M-Welsch/waberinator/readme.md

# Waberinator

Ambient LED driver unit for this guy: https://www.deviantart.com/seggos-artworks
