M-Welsch/waberinator/mech/waberinator_hw2.FCStd

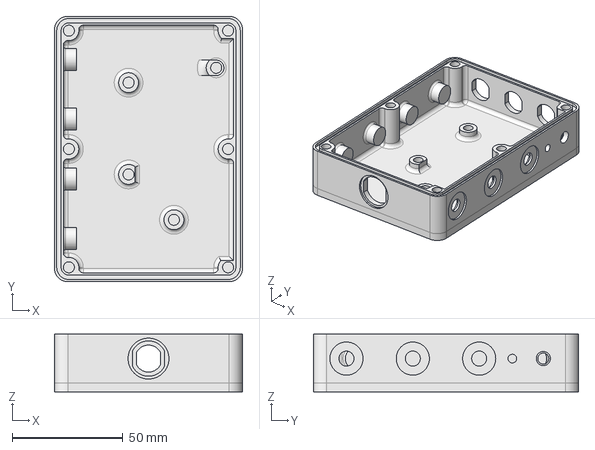
[picture p1: CAD file, 2024-07-26]
mech/waberinator_hw2.FCStd
85.0 x 120.0 x 26.0 mm
