M-Welsch/waberinator/pcb/waberinator_controlboard/design/flat.dxf

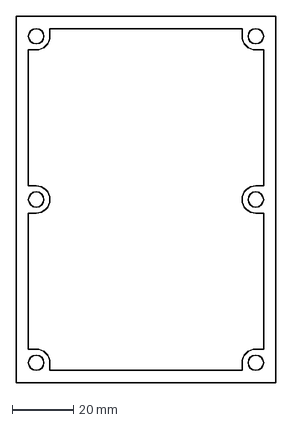
[picture p2: CAD file, 2024-02-20]
pcb/waberinator_controlboard/design/flat.dxf
85.0 x 120.0 mm
