M-Welsch/waberinator/mech/waberinator_connector_test.FCStd

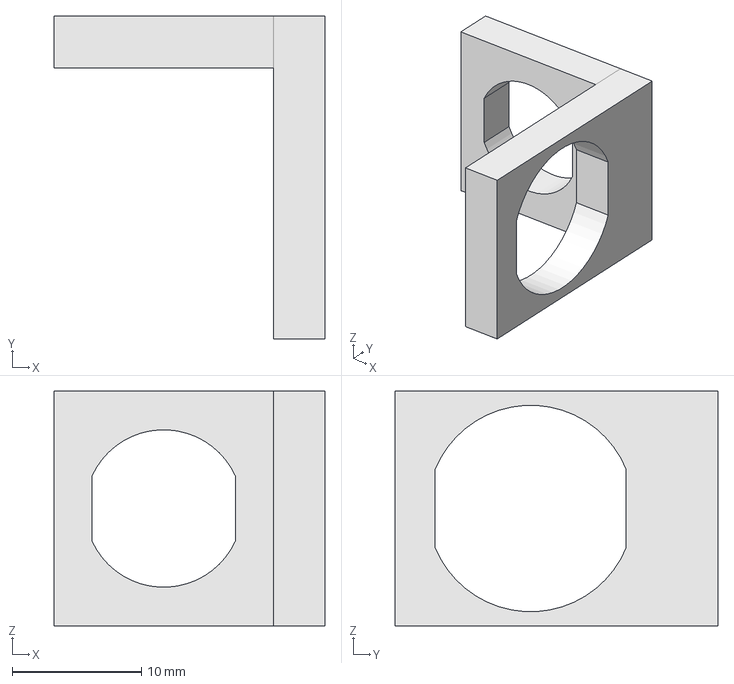
[picture p3: CAD file, 2024-04-21]
mech/waberinator_connector_test.FCStd
21.0 x 25.0 x 18.2 mm
