M-Welsch/waberinator/pcb/waberinator_controlboard/design/bol.dxf

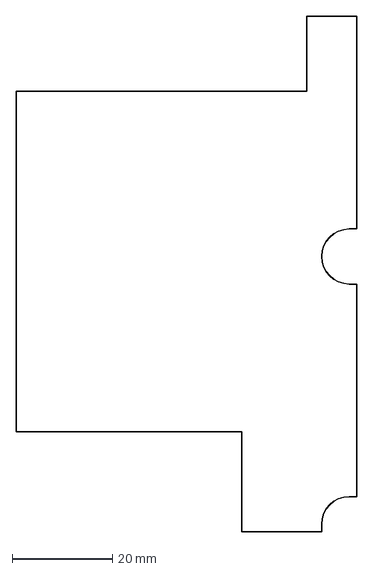
[picture p4: CAD file, 2024-02-20]
pcb/waberinator_controlboard/design/bol.dxf
68.0 x 103.0 mm
