M-Welsch/waberinator/mech/waberinator_hw2_controlboard.FCStd

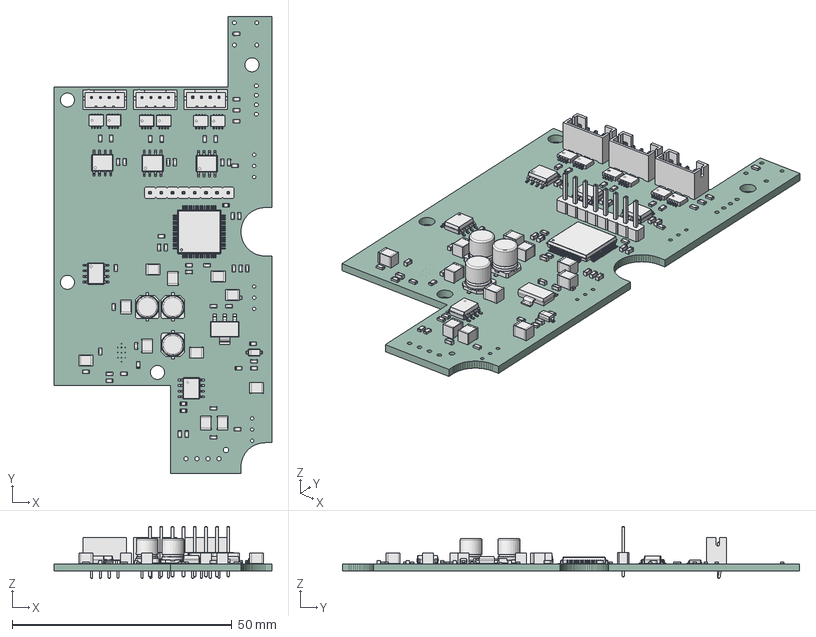
[picture p5: CAD file, 2024-03-04]
mech/waberinator_hw2_controlboard.FCStd
49.5 x 104.0 x 11.9 mm
SOIC_8_39x49mm_P127mm x 4
C_0603_1608Metric x 25
JST_B4B_PH_K x 3
C_1210_3225Metric x 11
R_0603_1608Metric x 27
SOT-1210_LFPAK33 x 6
R_0402_1005Metric x 6
D_SOD_123
C_Elec_5x58 x 3
CQ assembly
LQFP_64_10x10mm_P05mm
SOT_223
PinHeader_1x08_P254mm_Vertical
Waberinator_hw2 PCB
