M-Welsch/waberinator/mech/magnet_d12x3.FCStd

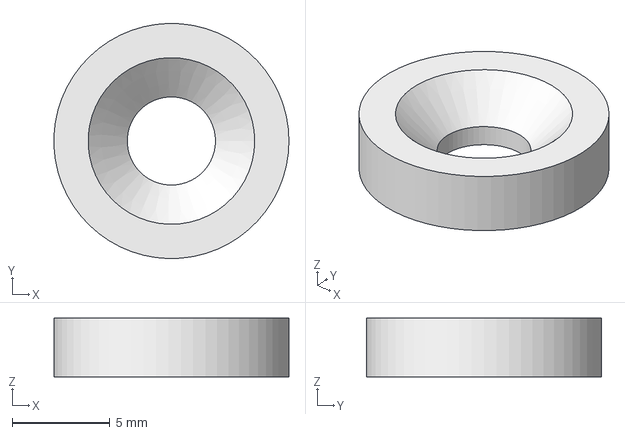
[picture p6: CAD file, 2024-02-18]
mech/magnet_d12x3.FCStd
12.0 x 12.0 x 3.00 mm
