M-Welsch/waberinator/mech/pushbutton_cover_v1.3mf

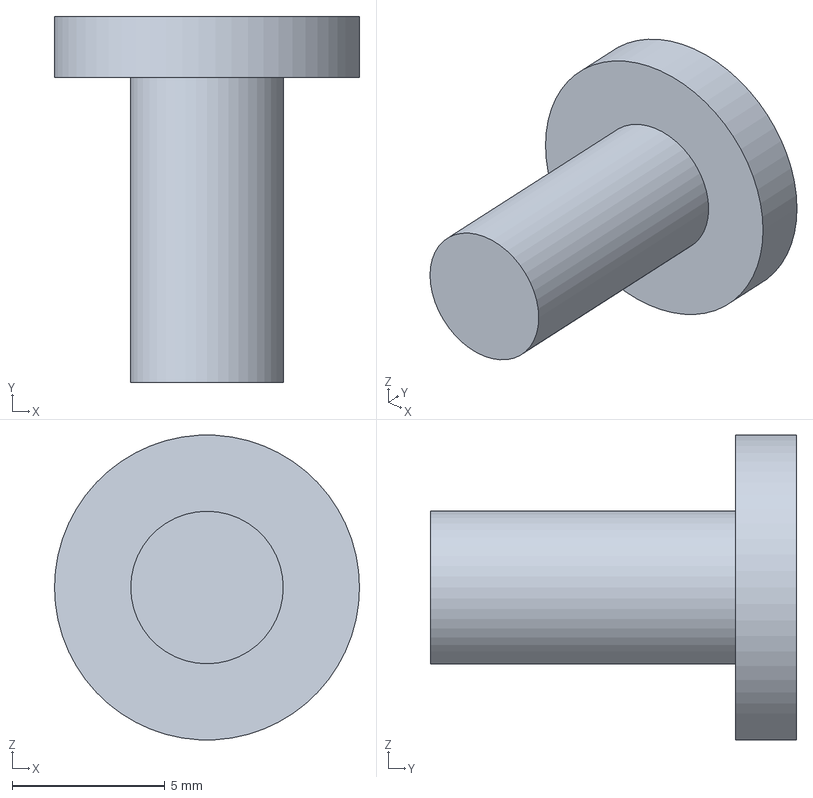
[picture p7: CAD file, 2024-02-17]
mech/pushbutton_cover_v1.3mf
10.0 x 12.0 x 9.99 mm
