M-Welsch/waberinator/mech/pushbutton_cover.FCStd

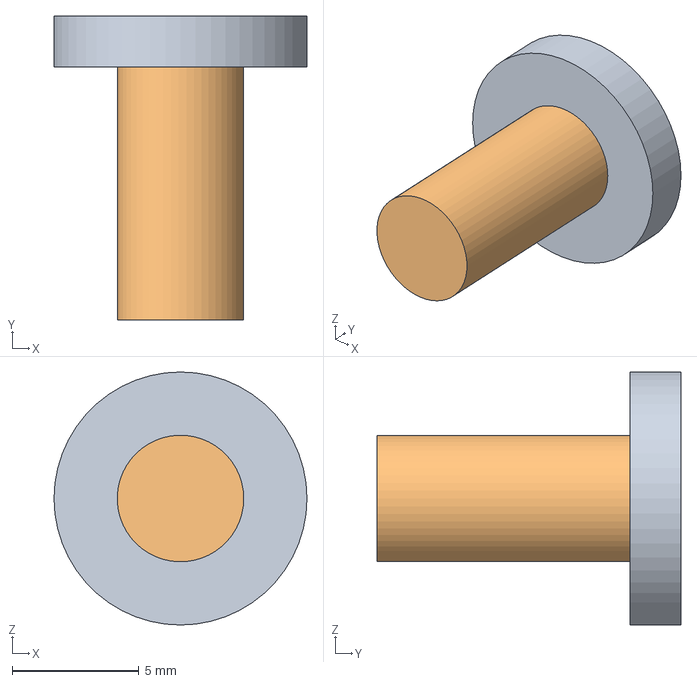
[picture p8: CAD file, 2024-01-04]
mech/pushbutton_cover.FCStd
10.0 x 12.0 x 10.0 mm
