M-Welsch/waberinator/pcb/waberinator_controlboard/design/Waberinator_hw2.kicad_pcb

## KiCad design pcb/waberinator_controlboard/design/Waberinator_hw2.kicad_pcb (2024-07-26)

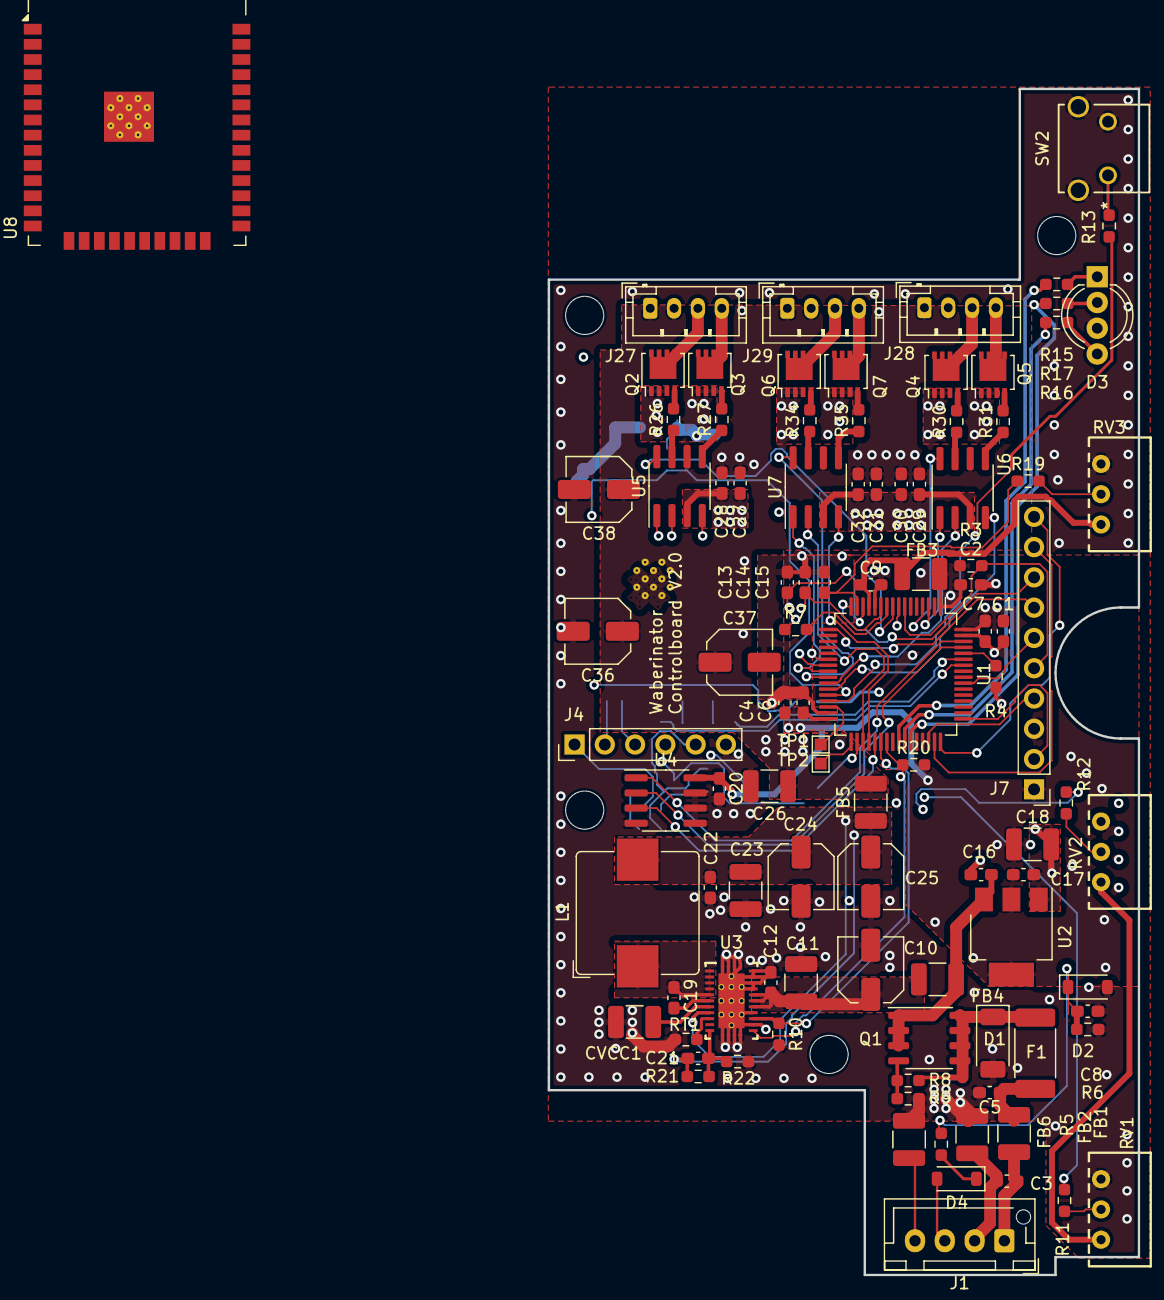
[picture p9: board Waberinator_hw2.kicad_pcb from above]

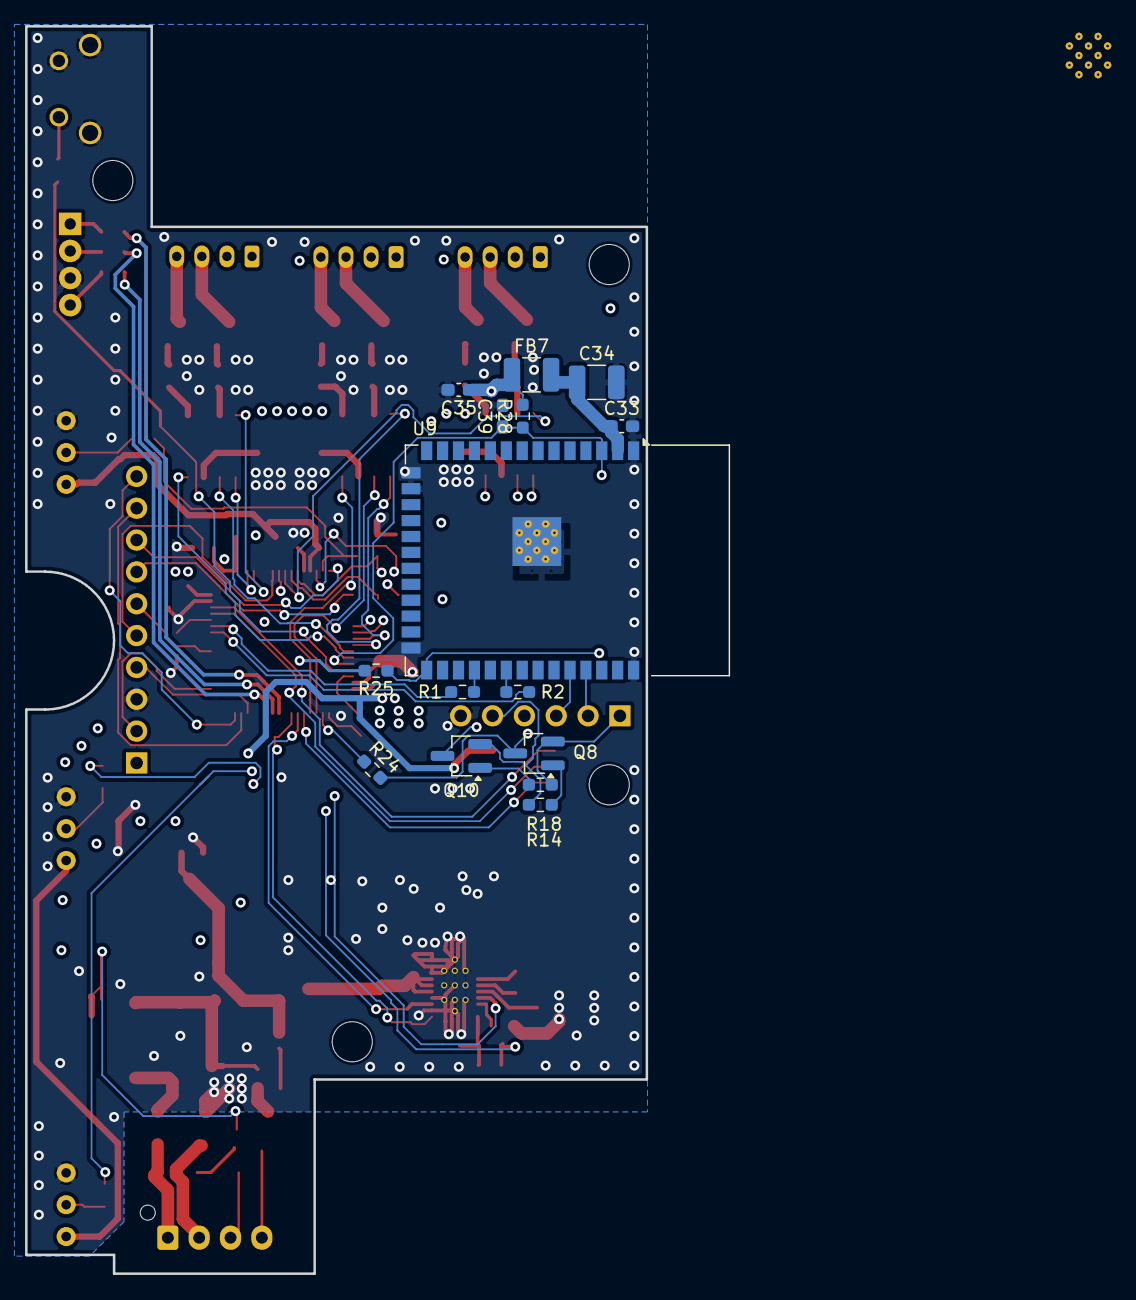
[picture p10: board Waberinator_hw2.kicad_pcb from below]

Board: 4 copper layers, 49.5 x 99.5 mm, 120 parts (15 on the bottom side), 98 nets.

Parts:
C1, C27, C29, C31, C39: 1µF; C_0603_1608Metric_Pad1.08x0.95mm_HandSolder
C2, C4, C6, C7, C8, C9, C16, C17, C20, C28, C30, C32, C33, C35: 100nF; C_0603_1608Metric_Pad1.08x0.95mm_HandSolder
C3, C5: C_0603_1608Metric_Pad1.08x0.95mm_HandSolder
C10, C24, C25, C36, C37, C38: 56µF; C_Elec_5x5.8
C11, C23, C26: 10µF; C_1210_3225Metric_Pad1.33x2.70mm_HandSolder
C12: 47nF; C_0603_1608Metric_Pad1.08x0.95mm_HandSolder
C13, C14, C15: 10n; C_0603_1608Metric_Pad1.08x0.95mm_HandSolder
C18: 22µF; C_1210_3225Metric_Pad1.33x2.70mm_HandSolder
C19, C22: 470nF; C_0603_1608Metric_Pad1.08x0.95mm_HandSolder
C21: 6.8pF; C_0603_1608Metric_Pad1.08x0.95mm_HandSolder
C34: 100µF; C_1210_3225Metric_Pad1.33x2.70mm_HandSolder
CVCC1: 2.2µF; C_1210_3225Metric_Pad1.33x2.70mm_HandSolder
D1: 824501121; D_SOD-128
D2, D4: SD103CW-E3-08; D_SOD-123
D3: RGB LED; LED_D5.0mm-4_RGB_Wide_Pins
F1: Fuse_2512_6332Metric_Pad1.52x3.35mm_HandSolder
FB1, FB2, FB3, FB4, FB5, FB6, FB7: FerriteBead; C_1210_3225Metric_Pad1.33x2.70mm_HandSolder
H1, H2, H3, H4: MountingHole; MountingHole_3.2mm_M3_DIN965
J1: Conn_01x04_Pin; JST_XH_B4B-XH-AM_1x04_P2.50mm_Vertical
J4: Conn_01x06; PinHeader_1x06_P2.54mm_Vertical
J7: Conn_01x10_Pin; PinHeader_1x10_P2.54mm_Vertical
J27, J28, J29: Conn_01x04; JST_PH_B4B-PH-K_1x04_P2.00mm_Vertical
L1: 744325330; L_Bourns_SRP1038C_10.0x10.0mm
NT2: NetTie_2; NetTie-2_SMD_Pad0.5mm
Q1: AOSP21321; SO-8_3.9x4.9mm_P1.27mm
Q2, Q3, Q4, Q5, Q6, Q7: SISHA04DN-T1-GE3; LFPAK33
Q8, Q10: Q_NPN_BEC; SOT-23_Handsoldering
R1, R2, R7, R9, R11, R12, R13, R17, R19, R24: 100; R_0603_1608Metric_Pad0.98x0.95mm_HandSolder
R3, R4, R5, R8, R10, R20, R21: 100k; R_0603_1608Metric_Pad0.98x0.95mm_HandSolder
R6: 24,9k; R_0603_1608Metric_Pad0.98x0.95mm_HandSolder
R14, R18, R28: 10k; R_0603_1608Metric_Pad0.98x0.95mm_HandSolder
R15, R16: 120; R_0603_1608Metric_Pad0.98x0.95mm_HandSolder
R22: 14.3k; R_0603_1608Metric_Pad0.98x0.95mm_HandSolder
R25: 5k; R_0603_1608Metric_Pad0.98x0.95mm_HandSolder
R26, R27, R30, R31, R34, R35: 1; R_0603_1608Metric_Pad0.98x0.95mm_HandSolder
RT1: 95k3; R_0603_1608Metric_Pad0.98x0.95mm_HandSolder
RV1: Brightness; poti_3310C-025-103L
RV2: Frequency; poti_3310C-025-103L
RV3: Depth; poti_3310C-025-103L
SW2: sw_te_1-1825027-1
TP1, TP2: TestPoint; TestPoint_Pad_1.0x1.0mm
U1: STM32F030R8Tx; LQFP-64_10x10mm_P0.5mm
U2: AMS1117-3.3; SOT-223-3_TabPin2
U3: LM73606QRNPRQ1; 30-WFQFN-RNP0030A
U4: LM75B; SOIC-8_3.9x4.9mm_P1.27mm
U5, U6, U7: MCP14A0304xMNY; SOIC-8_3.9x4.9mm_P1.27mm
U8: ESP32-WROOM-32
U9: ESP32-S3-WROOM-1

Connections:
+3.3VA: C9.1, FB3.2, RV1.1, RV2.1, RV3.1, U1.13 (VDDA)
+3V3: C1.1, C2.1, C4.1, C6.1, C7.1, C17.1, C18.1, C20.1, C35.1, FB3.1, FB7.1, J7.1, R3.1, R20.2, R25.2, R28.2, U1.1 (VDD), U1.32 (VDD), U1.64 (VDD), U2.2 (VO), U4.8 (+Vs)
/DC_IN+: C3.2, FB1.1, J1.1
/DC_IN-: C3.1, FB2.1, J1.2
/DC_prefuse: C5.1, F1.2, FB1.2
/DC_preprot: D1.1 (A1), F1.1, NT2.2, Q1.5 (D), Q1.6 (D), Q1.7 (D), Q1.8 (D)
/DC_prot: C16.1, FB4.1, Q1.1 (S), Q1.2 (S), Q1.3 (S), U2.3 (VI)
/Two Strings1/gate_a: Q4.4 (G), R30.2
/Two Strings1/gate_b: Q5.4 (G), R31.2
/Two Strings1/low_a: J28.3, Q4.5 (D)
/Two Strings1/low_b: J28.4, Q5.5 (D)
/Two Strings1/out_a: R30.1, U6.7 (OUTA)
/Two Strings1/out_b: R31.1, U6.5 (OUTB)
/Two Strings2/gate_a: Q6.4 (G), R34.2
/Two Strings2/gate_b: Q7.4 (G), R35.2
/Two Strings2/low_a: J29.3, Q6.5 (D)
/Two Strings2/low_b: J29.4, Q7.5 (D)
/Two Strings2/out_a: R34.1, U7.7 (OUTA)
/Two Strings2/out_b: R35.1, U7.5 (OUTB)
/Two Strings/gate_a: Q2.4 (G), R26.2
/Two Strings/gate_b: Q3.4 (G), R27.2
/Two Strings/low_a: J27.3, Q2.5 (D)
/Two Strings/low_b: J27.4, Q3.5 (D)
/Two Strings/out_a: R26.1, U5.7 (OUTA)
/Two Strings/out_b: R27.1, U5.5 (OUTB)
/U0RXD_ESP32: J4.3, U9.36 (RXD0)
/U0TXD_ESP32: J4.2, U9.37 (TXD0)
/U1RXD_ESP32: R2.1, U9.11 (IO18)
/U1TXD_ESP32: R1.1, U9.10 (IO17)
/VLed: C26.1, C27.1, C28.1, C29.1, C30.1, C31.1, C32.1, C36.1, C37.1, C38.1, FB5.2, J27.1, J27.2, J28.1, J28.2, J29.1, J29.2, U5.6 (V+), U6.6 (V+), U7.6 (V+)
/adc_brightness: C13.1, R11.1, U1.14 (PA0)
/adc_depth: C15.1, R19.1, U1.15 (PA1)
/adc_frequency: C14.1, R12.1, U1.11 (PC3)
/bat_kelvin+: D4.2 (A), J1.3
/bat_kelvin-: FB6.1, J1.4
/boot0: R4.2, U1.60 (BOOT0)
/button1: R13.1, U1.29 (PB10)
/esp32_en: C39.1, Q10.3 (C), R28.1, U1.28 (PB2), U9.3 (EN)
/esp32_io0: Q8.3 (C), R24.2, R25.1, U9.27 (IO0)
/esp32_prog_dtr: J4.1, Q8.2 (E), R14.1
/esp32_prog_rts: J4.5, Q10.2 (E), R18.1
/esp32_vdd: C33.1, C34.1, FB7.2, U9.2 (3V3)
/i2c1_scl: U1.61 (PB8), U4.2 (SCL)
/i2c1_sda: U1.62 (PB9), U4.1 (SDA)
/ledstring1_drv_en: U1.8 (PC0), U5.1 (ENA)
/ledstring2_drv_en: U1.9 (PC1), U5.8 (ENB)
/ledstring3_drv_en: U1.3 (PC14), U6.1 (ENA)
/ledstring4_drv_en: U1.4 (PC15), U6.8 (ENB)
/ledstring5_drv_en: U1.24 (PC4), U7.1 (ENA)
/ledstring6_drv_en: U1.25 (PC5), U7.8 (ENB)
/lm75b_int: U1.37 (PC6), U4.3 (O.S.)
/lm73606_en: R10.1, U1.38 (PC7), U3.18 (EN)
/lm73606_out: C21.1, C22.1, C23.1, C24.1, C25.1, FB5.1, L1.2, R21.1, U3.8 (BIAS)
/lm73606_pg: R20.1, U1.39 (PC8), U3.16 (PGOOD)
/lm_fb: C21.2, R21.2, R22.1, U3.11 (FB)
/lm_rt: RT1.2, U3.9 (RT)
/lm_sw: C19.2, L1.1, U3.1 (SW), U3.2 (SW), U3.3 (SW), U3.4 (SW), U3.5 (SW)
/lm_vcc: CVCC1.1, U3.7 (VCC)
/lm_vin: C10.1, C11.1, C12.1, FB4.2, U3.20 (VIN), U3.21 (VIN), U3.22 (VIN)
/spare_1: J7.9, U1.47 (PF6)
/spare_2: J7.10, U1.48 (PF7)
/spare_3: TP1.1, U1.30 (PB11)
/spare_4: TP2.1, U1.33 (PB12)
/swd_swo: J7.6, U1.55 (PB3)
/swd_tck: J7.2, U1.49 (PA14)
/swd_tms: J7.4, U1.46 (PA13)
/tim1_ch1_indicator_led1: R15.1, U1.41 (PA8)
/tim1_ch2_indicator_led2: R16.1, U1.42 (PA9)
/tim1_ch3_indicator_led3: R17.1, U1.43 (PA10)
/tim3_ch1_ledstring1: U1.22 (PA6), U5.2 (INA)
/tim3_ch2_ledstring2: U1.23 (PA7), U5.4 (INB)
/tim3_ch3_ledstring3: U1.26 (PB0), U6.2 (INA)
/tim3_ch4_ledstring4: U1.27 (PB1), U6.4 (INB)
/tim15_ch1_ledstring5: U1.35 (PB14), U7.2 (INA)
/tim15_ch2_ledstring6: U1.36 (PB15), U7.4 (INB)
/usart1_rx_mcu: R1.2, U1.59 (PB7)
/usart1_tx_mcu: R2.2, U1.58 (PB6)
/usart2_rx_mcu: J7.7, U1.17 (PA3)
/usart2_tx_mcu: J7.8, U1.16 (PA2)
/vbat_meas: R7.2, U1.10 (PC2)
/~rst: J7.5, R3.2, U1.7 (NRST)
unnamed: C8.1, D2.1 (K), R5.1, R6.2, R7.1
unnamed: D3.1 (BA), R15.2
unnamed: D3.4 (GA), R16.2
unnamed: D3.2 (RA), R17.2
unnamed: D4.1 (K), R5.2
unnamed: NT2.1, R8.1
unnamed: Q1.4 (G), R8.2, R9.1
unnamed: Q8.1 (B), R18.2
unnamed: Q10.1 (B), R14.2
unnamed: R11.2, RV1.2
unnamed: R12.2, RV2.2
unnamed: R13.2, SW2.1
unnamed: R19.2, RV3.2
unnamed: R24.1, U1.34 (PB13)
unnamed: C19.1, U3.6 (CBOOT)
unnamed: U8.1 (GND), U8.15 (GND), U8.38 (GND), U8.39 (GND)
RET: C1.2, C2.2, C4.2, C5.2, C6.2, C7.2, C8.2, C9.2, C10.2, C11.2, C12.2, C13.2, C14.2, C15.2, C16.2, C17.2, C18.2, C20.2, C22.2, C23.2, C24.2, C25.2, C26.2, C27.2, C28.2, C29.2, C30.2, C31.2, C32.2, C33.2, C34.2, C35.2, C36.2, C37.2, C38.2, C39.2, CVCC1.2, D1.2 (A2), D2.2 (A), D3.3 (K), FB2.2, FB6.2, J4.6, J7.3, Q2.1 (S), Q2.2 (S), Q2.3 (S), Q3.1 (S), Q3.2 (S), Q3.3 (S), Q4.1 (S), Q4.2 (S), Q4.3 (S), Q5.1 (S), Q5.2 (S), Q5.3 (S), Q6.1 (S), Q6.2 (S), Q6.3 (S), Q7.1 (S), Q7.2 (S), Q7.3 (S), R4.1, R6.1, R9.2, R10.2, R22.2, RT1.1, RV1.3, RV2.3, RV3.3, SW2.2, SW2.3, SW2.4, U1.12 (VSSA), U1.31 (VSS), U1.63 (VSS), U2.1 (GND), U3.12 (NC), U3.13 (NC), U3.14 (NC), U3.15 (NC), U3.17 (SYNC), U3.19 (AGND), U3.23 (PGND), U3.24 (PGND), U3.25 (PGND), U3.26 (PGND), U3.27 (NC), U3.28 (NC), U3.29 (NC), U3.30 (NC), U3.31 (DAP), U4.4 (GND), U4.5 (A2), U4.6 (A1), U4.7 (A0), U5.3 (GND), U6.3 (GND), U7.3 (GND), U9.1 (GND), U9.40 (GND), U9.41 (GND)
