M-Welsch/waberinator/pcb/waberinator_lichterkette/design/waberinator_lichterkette.kicad_pcb

## KiCad design pcb/waberinator_lichterkette/design/waberinator_lichterkette.kicad_pcb (2024-02-23)

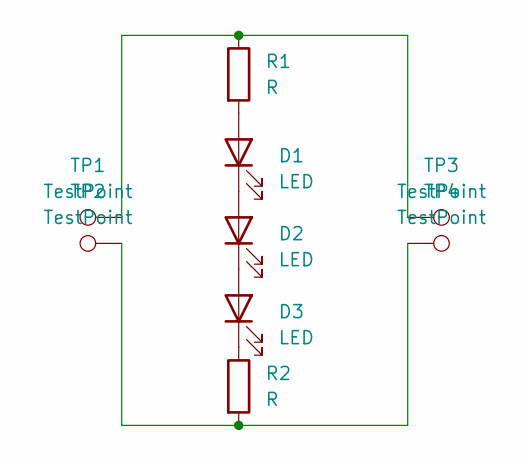
[picture p11: schematic waberinator_lichterkette.kicad_sch]

Parts:
D1, D2, D3: LED; LED_1812_4532Metric_Pad1.30x3.40mm_HandSolder
R1, R2: R; R_1210_3225Metric_Pad1.30x2.65mm_HandSolder
TP1, TP2, TP3, TP4: TestPoint; TestPoint_Loop_D3.80mm_Drill2.5mm

Connections:
unnamed: D1.2 (A), R1.2
unnamed: D1.1 (K), D2.2 (A)
unnamed: D2.1 (K), D3.2 (A)
unnamed: D3.1 (K), R2.1
unnamed: R1.1, TP1.1, TP3.1
unnamed: R2.2, TP2.1, TP4.1

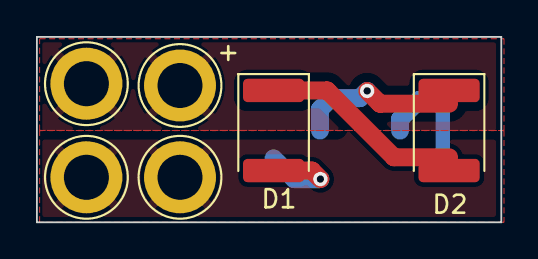
[picture p12: board waberinator_lichterkette.kicad_pcb from above]

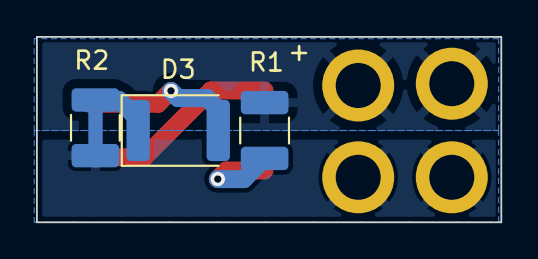
[picture p13: board waberinator_lichterkette.kicad_pcb from below]

Board: 2 copper layers, 25.8 x 10.3 mm, 9 parts (3 on the bottom side), 6 nets.
