M-Welsch/waberinator/firmware/wabering/main.c

#define TEST 1

#include "wabering.h"
#include <stdio.h>

int main(void) {
    waber_led_cfg_t cfg;
    cfg.phase = 0;
    cfg.depth = 0.7;
    cfg.frequency = 1;
    cfg.max_brightness = 1;
    cfg.smoothness = 2;

    printf("Testing Compressorfunc:\n");
    for (uint32_t c = 0; c < 100; c++) {
        float inp = (float) c / 100;
        printf("%f, %f\n", inp, _compressor(inp, cfg.smoothness));
    }

    printf("Testing Sinefunc:\n");
    for (uint32_t c = 0; c < 100; c++) {
        printf("%ld, %f\n", c, _sine(c, cfg.frequency, cfg.phase));
    }

    printf("Testing Compressed Sine:\n");
    for (uint32_t c = 0; c < 100; c++) {
        float inp = (float) c / 100;
        printf("%ld, %f\n", c, _compressed_sine(c, cfg.frequency, cfg.phase, cfg.smoothness));
    }

    printf("Testing Waberfunc Float:\n");
    for (uint32_t c = 0; c < 100; c++) {
        float tick_f = (float) c;
        printf("%ld, %f\n", c, waber(tick_f, &cfg, 1.0f, 1.0f));
    }

    printf("Testing Waberfunc Int:\n");
    for (uint32_t c = 0; c < 100; c++) {
        float tick_f = (float) c;
        printf("%ld, %d\n", c, waber(tick_f, &cfg, 1.0f, 1.0f));
    }
}
