M-Welsch/waberinator/firmware/wabering/waber_thread.c

#include "ch.h"
#include "hal.h"
#include "chprintf.h"
#include "led_string.h"
#include "waber_thread.h"
#include "wab_mutex.h"
#include "adc.h"


waberinator_config_t waber_config;

int _wabercfg_init(void) {
    waber_led_cfg_t waber_led_cfg[6];
    waber_led_cfg[0].phase = 0;
    waber_led_cfg[0].depth = 1.0f;
    waber_led_cfg[0].frequency = 0.3f;
    waber_led_cfg[0].max_brightness = 1.0f;
    waber_led_cfg[0].momentary_brightness = 0.5f;
    waber_led_cfg[0].smoothness = 4;

    waber_led_cfg[1].phase = 1.04f;
    waber_led_cfg[1].depth = 1.0f;
    waber_led_cfg[1].frequency = 0.3f;
    waber_led_cfg[1].max_brightness = 1.0f;
    waber_led_cfg[1].momentary_brightness = 0.6f;
    waber_led_cfg[1].smoothness = 4;

    waber_led_cfg[2].phase = 2.94f;
    waber_led_cfg[2].depth = 1.0f;
    waber_led_cfg[2].frequency = 0.3f;
    waber_led_cfg[2].max_brightness = 1.0f;
    waber_led_cfg[2].momentary_brightness = 0.7f;
    waber_led_cfg[2].smoothness = 4;

    waber_led_cfg[3].phase = 3.1415f;
    waber_led_cfg[3].depth = 1.0f;
    waber_led_cfg[3].frequency = 0.3f;
    waber_led_cfg[3].max_brightness = 1.0f;
    waber_led_cfg[3].momentary_brightness = 0.8f;
    waber_led_cfg[3].smoothness = 4;

    waber_led_cfg[4].phase = 4.1888f;
    waber_led_cfg[4].depth = 1.0f;
    waber_led_cfg[4].frequency = 0.3f;
    waber_led_cfg[4].max_brightness = 1.0f;
    waber_led_cfg[4].momentary_brightness = 0.9f;
    waber_led_cfg[4].smoothness = 4;

    waber_led_cfg[5].phase = 5.2398f;
    waber_led_cfg[5].depth = 1.0f;
    waber_led_cfg[5].frequency = 0.3f;
    waber_led_cfg[5].max_brightness = 1.0f;
    waber_led_cfg[5].momentary_brightness = 1;
    waber_led_cfg[5].smoothness = 4;

    waber_config.global_min_brightness = 0.0f;
    waber_config.global_max_brightness = 1.0f;
    waber_config.global_min_frequency = ABSOLUTE_MINIMUM_FREQUENCY;
    waber_config.global_max_frequency = 2.0f;
    waber_config.global_min_depth = 0.0f;
    waber_config.global_max_depth = 1.0f;
    waber_config.manual_mode = false;
    waber_config.synchronous = false;
    waber_config.led_cfg[0] = waber_led_cfg[0];
    waber_config.led_cfg[1] = waber_led_cfg[1];
    waber_config.led_cfg[2] = waber_led_cfg[2];
    waber_config.led_cfg[3] = waber_led_cfg[3];
    waber_config.led_cfg[4] = waber_led_cfg[4];
    waber_config.led_cfg[5] = waber_led_cfg[5];
    return 0;
}

/**
 * @brief the whole adc range (0..1) shall be spread over global_min_something and global_max_something
 * to have more tactile precision with the potis.
 * Literally speaking: the Poti can adjust only between a limited range of values like between 0.3 and 0.7
 *
 *   y ^
 *     |
 * max |  /
 *     | /
 * min |/
 *     |
 *     +------> x
 *     0   1
 *
 *     y = f(x) = (max - min) * x + min
 * @param adc_val
 * @param min
 * @param max
 * @return a nice float
 */
float _map_full_adc_range_to_defined_range(float adc_val, float min, float max) {
    return (max - min) * adc_val + min;
}

static THD_WORKING_AREA(waberThread, 1024);
static THD_FUNCTION(waberThread1, arg) {
    (void) arg;
    chRegSetThreadName("waberthread1");
    systime_t time = chVTGetSystemTimeX();

    float brightness[6] = {0};
    uint32_t tick = 0;

    _wabercfg_init();

    systime_t time_start = 0;
    systime_t time_needed = 0;
    systime_t time_available = TIME_MS2I(WABER_TICK_MS);
    systime_t time_max = 0;
    bool read_manual_mode = false;

    float brightness_factor = 1.0f;
    float frequency_factor = 1.0f;
    float depth_factor = 1.0f;
    adc_readings_t adc_readings;
#ifdef ADC_TEST
    while (true) {
        adc_readPoti(&adc_readings);
        chprintf((BaseSequentialStream*) &SD2, "ADC vals: %f, %f, %f, %f\n", adc_readings.brightness, adc_readings.depth, adc_readings.frequency, adc_readings.vbat);
        chThdSleepMilliseconds(200);
    }
#endif

    while (true) {

        chMtxLock(&mtx_waber_cfg);
        read_manual_mode = waber_config.manual_mode;
        chMtxUnlock(&mtx_waber_cfg);
        if (!read_manual_mode) {
            chMtxLock(&mtx_waber_cfg);
            led_string_setBrightness(1, brightness[0]);
            led_string_setBrightness(2, brightness[1]);
            led_string_setBrightness(3, brightness[2]);
            led_string_setBrightness(4, brightness[3]);
            led_string_setBrightness(5, brightness[4]);
            led_string_setBrightness(6, brightness[5]);
            chMtxUnlock(&mtx_waber_cfg);

            time_start = chVTGetSystemTimeX();
            time += TIME_MS2I(WABER_TICK_MS);

            chMtxLock(&mtx_adc);
            adc_readPoti(&adc_readings);
            chMtxUnlock(&mtx_adc);

            float depth = adc_readings.depth ;
            if (adc_readings.depth > 0.5) {  // waber synchronuously if depth knob is greater than 0.5
                waber_config.synchronous = true;
                depth -= 0.5f;
            }
            else {
                waber_config.synchronous = false;
            }
            depth *= 2;

            chMtxLock(&mtx_waber_cfg);
            brightness_factor = _map_full_adc_range_to_defined_range(adc_readings.brightness, waber_config.global_min_brightness, waber_config.global_max_brightness);
            frequency_factor = _map_full_adc_range_to_defined_range(adc_readings.frequency, waber_config.global_min_frequency, waber_config.global_max_frequency);
            depth_factor = _map_full_adc_range_to_defined_range(depth, waber_config.global_min_depth, waber_config.global_max_depth);

            brightness[0] = waber(tick, &waber_config.led_cfg[0], frequency_factor, depth_factor) * brightness_factor;
            if (waber_config.synchronous) {
                brightness[1] = brightness[0];
                brightness[2] = brightness[0];
                brightness[3] = brightness[0];
                brightness[4] = brightness[0];
                brightness[5] = brightness[0];
            }
            else {
                brightness[1] = waber(tick, &waber_config.led_cfg[1], frequency_factor, depth_factor) * brightness_factor;
                brightness[2] = waber(tick, &waber_config.led_cfg[2], frequency_factor, depth_factor) * brightness_factor;
                brightness[3] = waber(tick, &waber_config.led_cfg[3], frequency_factor, depth_factor) * brightness_factor;
                brightness[4] = waber(tick, &waber_config.led_cfg[4], frequency_factor, depth_factor) * brightness_factor;
                brightness[5] = waber(tick, &waber_config.led_cfg[5], frequency_factor, depth_factor) * brightness_factor;
            }
            chMtxUnlock(&mtx_waber_cfg);
            tick++;
            time_needed = chVTGetSystemTimeX() - time_start;
            if (time_needed > time_max) {
                time_max = time_needed;
            }
#ifdef MEASURE_TICKS  // might break the flow!
            if (tick % 50 == 0) {
                chprintf((BaseSequentialStream*) &SD2, "Maximum Time needed: %d of %d: [%f, %f, %f, %f, %f, %f]\n\r", time_max, time_available, brightness[0], brightness[1], brightness[2], brightness[3], brightness[4], brightness[5]);
            }
#endif
            chThdSleepUntil(time);
        }
        else {
            // manual mode
            chMtxLock(&mtx_waber_cfg);
            led_string_setBrightness(1, waber_config.led_cfg[0].momentary_brightness);
            led_string_setBrightness(2, waber_config.led_cfg[1].momentary_brightness);
            led_string_setBrightness(3, waber_config.led_cfg[2].momentary_brightness);
            led_string_setBrightness(4, waber_config.led_cfg[3].momentary_brightness);
            led_string_setBrightness(5, waber_config.led_cfg[4].momentary_brightness);
            led_string_setBrightness(6, waber_config.led_cfg[5].momentary_brightness);
            chMtxUnlock(&mtx_waber_cfg);
            chThdSleepMilliseconds(100);
        }
    }
}

void waberthread_init(void) {
    chThdCreateStatic(waberThread, sizeof(waberThread), HIGHPRIO, waberThread1, NULL);
}

int waberthread_set_manual_mode(const bool set_manual_mode) {
    chMtxLock(&mtx_waber_cfg);
    waber_config.manual_mode = set_manual_mode;
    chMtxUnlock(&mtx_waber_cfg);
    return 0;
}

int waberthread_set_cfg(uint8_t led_channel, wabercfg_parameter_e parameter, float value) {
    int retval = 0;
    chMtxLock(&mtx_waber_cfg);  // get stuck here when this is being called for the second time
    switch (parameter) {
        case WABER_CFG_PHASE:
            waber_config.led_cfg[led_channel].phase = value;
            break;
        case WABER_CFG_DEPTH:
            if ((value > 1.0f) || (value < 0.0f)) {
                retval = -1;
            }
            else {
                waber_config.led_cfg[led_channel].depth = value;
            }
            break;
        case WABER_CFG_FREQUENCY:
            if (value < ABSOLUTE_MINIMUM_FREQUENCY) {
                retval = -1;
            }
            else {
                waber_config.led_cfg[led_channel].frequency = value;
            }
            break;
        case WABER_CFG_MAX_BRIGHTNESS:
            if ((value > 1.0f) || (value < 0.0f)) {
                retval = -1;
            }
            else {
                waber_config.led_cfg[led_channel].max_brightness = value;
            }
            break;
        case WABER_CFG_MOMENTARY_BRIGHTNESS:
            if ((value > 1.0f) || (value < 0.0f)) {
                retval = -1;
            }
            else {
                waber_config.led_cfg[led_channel].momentary_brightness = value;
            }
            break;
        case WABER_CFG_SMOOTHNESS:
            waber_config.led_cfg[led_channel].smoothness = value;
            break;
        case WABER_CFG_ACTIVE:
            waber_config.led_cfg[led_channel].active = value > 0.5;
            if (waber_config.led_cfg[led_channel].active) {
                led_string_on(led_channel);
            }
            else {
                led_string_off(led_channel);
            }
            break;
        default:
            retval = -1;
    }
    chMtxUnlock(&mtx_waber_cfg);
    return retval;
}

int waberthread_get_cfg(uint8_t led_channel, wabercfg_parameter_e parameter, float *value) {
    if (value == NULL) {
        return -1;
    }
    int retval = 0;
    chMtxLock(&mtx_waber_cfg);
    switch (parameter) {
        case WABER_CFG_PHASE:
            *value = waber_config.led_cfg[led_channel].phase;
            break;
        case WABER_CFG_DEPTH:
            *value = waber_config.led_cfg[led_channel].depth;
            break;
        case WABER_CFG_FREQUENCY:
            *value = waber_config.led_cfg[led_channel].frequency;
            break;
        case WABER_CFG_MAX_BRIGHTNESS:
            *value = waber_config.led_cfg[led_channel].max_brightness;
            break;
        case WABER_CFG_SMOOTHNESS:
            *value = waber_config.led_cfg[led_channel].smoothness;
            break;
        default:
            retval = -1;
    }
    chMtxUnlock(&mtx_waber_cfg);
    return retval;
}

int waberthread_get_complete_cfg(uint8_t led_channel, waber_led_cfg_t *cfg) {
    chMtxLock(&mtx_waber_cfg);
    cfg->phase = waber_config.led_cfg[led_channel].phase;
    cfg->depth = waber_config.led_cfg[led_channel].depth;
    cfg->frequency = waber_config.led_cfg[led_channel].frequency;
    cfg->max_brightness = waber_config.led_cfg[led_channel].max_brightness;
    cfg->smoothness = waber_config.led_cfg[led_channel].smoothness;
    chMtxUnlock(&mtx_waber_cfg);
    return 0;
}
