M-Welsch/waberinator/(commit log)

2024-01-01 hardware prepared for ebay-lichterketten. Deprecated though
    [Waberinator_hw2.kicad_pcb, Waberinator_hw2.kicad_sch, Waberinator_rev1.kicad_pcb, Waberinator_rev1.kicad_sch]
2024-01-01 prepared for stm32f030. Assigned pins for timers and adcs. Selected mosfets and drivers
    [Waberinator_hw2.kicad_pcb, Waberinator_hw2.kicad_sch]
2024-01-02 progress on schematic
    [WBPerformanceSummaryDesign5.csv, Waberinator_hw2.kicad_sch]
2024-01-04 add lichterkette
    [Waberinator_hw2.kicad_pcb, Waberinator_hw2.kicad_sch, pushbutton_cover.FCStd, waberinator_lichterkette.kicad_pcb, waberinator_lichterkette.kicad_sch]
2024-02-13 [PCB] components roughly placed
    [Waberinator_hw2.kicad_pcb, Waberinator_hw2.kicad_sch, two_strings.kicad_sch, waberinator_lichterkette.kicad_pcb]
2024-02-17 [HW] draft chassis
    [Waberinator_hw2.kicad_pcb, Waberinator_hw2.kicad_sch, pushbutton_cover_v1.3mf, two_strings.kicad_sch, waberinator_hw2.FCStd]
2024-02-18 [HW] moved lights connector to top
    [Waberinator_hw2.kicad_pcb, Waberinator_hw2.kicad_sch, two_strings.kicad_sch, waberinator_hw2.FCStd]
2024-02-18 [HW] Details
    [Waberinator_hw2.kicad_pcb, magnet_d12x3.FCStd, two_strings.kicad_sch, waberinator_hw2.FCStd]
2024-02-20 finalize BOL
    [Waberinator_hw2.kicad_pcb, bol.dxf, flat.dxf, waberinator_hw2.FCStd]
2024-02-20 finish chassis
    [waberinator_hw2.FCStd]
2024-02-22 [HW] pcb production ready
    [Waberinator_hw2.kicad_pcb, Waberinator_hw2.kicad_sch, two_strings.kicad_sch, waberinator_hw2.FCStd]
2024-02-23 [HW] finish layout
    [Waberinator_hw2.kicad_pcb, Waberinator_hw2.kicad_sch, two_strings.kicad_sch, waberinator_hw2.FCStd, waberinator_lichterkette.kicad_pcb]
2024-03-04 [FW] configure board.h
2024-03-04 [HW] misc adjustments to mechanics
    [Waberinator_hw2.kicad_pcb, Waberinator_hw2.kicad_sch, two_strings.kicad_sch, waberinator_hw2.FCStd, waberinator_hw2_controlboard.FCStd]
2024-03-11 [FW] implement wabering thread
2024-03-12 [HW/FW] reshape board to get special offer, reassign some pins
    [Waberinator_hw2.kicad_pcb, Waberinator_hw2.kicad_sch]
2024-03-15 [FW] basic PWM with TIM1 runs
2024-03-17 [FW] enhance shell powers and refactor
2024-03-17 [FW] introduce drivers
2024-03-18 [HW] add esp32
    [Waberinator_hw2.kicad_pcb, Waberinator_hw2.kicad_sch, two_strings.kicad_sch]
2024-03-21 [FW] add uart shell for esp32/modem (not mutexed)
2024-03-21 [FW] remove unused shell thread
2024-03-21 [HW/FW] control power state of modem
    [Waberinator_hw2.kicad_pcb, Waberinator_hw2.kicad_sch]
2024-04-12 feat(modem): uart2 works
2024-04-14 bugfix(mcu): remove race condition with waber_led_cfg o invalid value
    [waber_thread.c]
2024-04-16 feat(mcu): implement adc
2024-04-21 [HW] fix esp32 footprint and symbol
    [Waberinator_hw2.kicad_pcb, Waberinator_hw2.kicad_sch]
2024-04-21 [HW] fix mechanic bugs
    [waberinator_connector_test.FCStd, waberinator_hw2.FCStd]
2024-04-28 [HW] misc changes
    [Waberinator_hw2.kicad_pcb, Waberinator_hw2.kicad_sch, waberinator_hw2.FCStd]
2024-05-04 bugfix(chassis): add space for poti o-ring
    [waberinator_hw2.FCStd]
2024-05-04 bugfix(chassis): add pen-tip-boempel. The thing that is on pens that you can operate touchscreens with
    [waberinator_hw2.FCStd]
2024-05-04 bugfix(chassis): make space for the led pins and the pushbutton pins
    [waberinator_hw2.FCStd]
2024-05-04 feat(cableplan): add rudimentary cableplan to driver schematic sheet
    [two_strings.kicad_sch]
2024-05-04 feat(mech): add pockets for orings around gx connectors
    [waberinator_hw2.FCStd]
2024-06-06 [FW] getter for adc
2024-06-06 [FW] adjust (not optimize) pwm settings for smoother wabering
2024-07-19 [FW] status LED works
2024-07-19 [FW] button integration, button state not correct though
    [battery_monitor.c, board.h, main.c]
2024-07-20 [FW] optimized PWM, blinks RED on UV
2024-07-21 [FW] for some reason it doesn't start anymore
    [battery_monitor.c, battery_monitor.h]
2024-07-26 [HW] bugfixes
    [Waberinator_hw2.kicad_pcb, Waberinator_hw2.kicad_sch, two_strings.kicad_sch, waberinator_hw2.FCStd]
